CodreanuDan/ECG_Monitor-ECG_Mon/Docs/2/ECG_Presentation_PDF.pdf

# Dispozitiv de monitorizare a

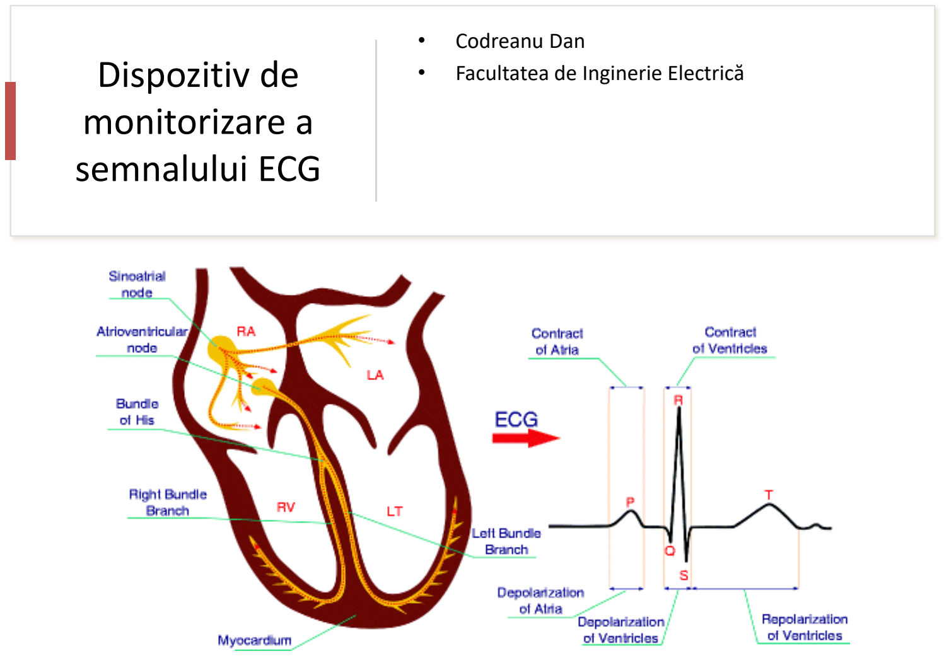
[picture p47: page 1]

# semnalului ECG

- Codreanu Dan
- Facultatea de Inginerie Electrică

# Context & Stadiul actual

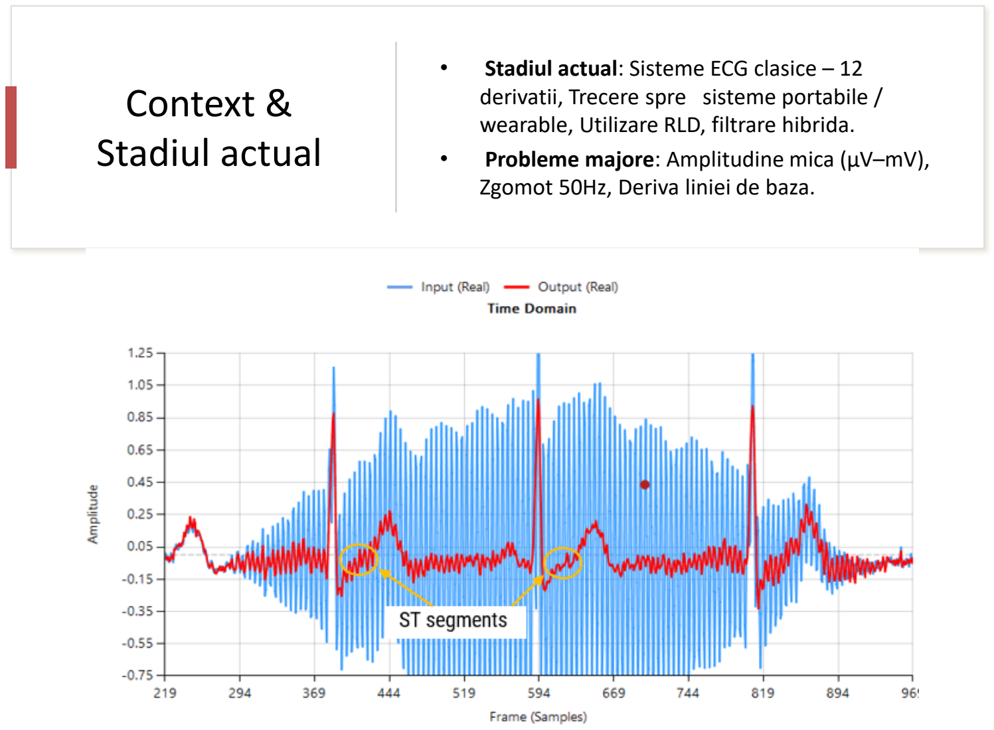
[picture p48: page 2]

- Stadiul actual: Sisteme ECG clasice – 12 derivatii, Trecere spre sisteme portabile / wearable, Utilizare RLD, filtrare hibrida.
- Probleme majore: Amplitudine mica (µV–mV), Zgomot 50Hz, Deriva liniei de baza.

# Obiectivul lucrarii

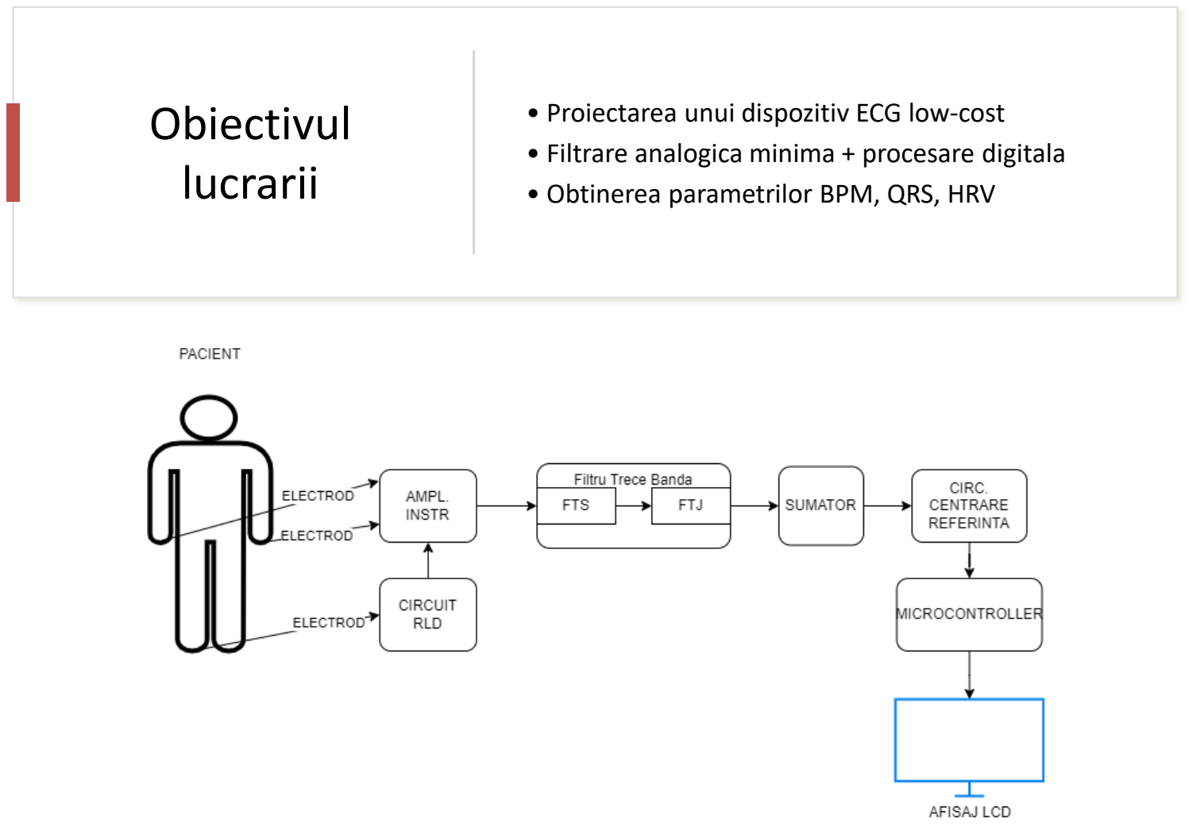
[picture p49: page 3]

- Proiectarea unui dispozitiv ECG low

-cost
- Filtrare analogica minima + procesare digitala
- Obtinerea parametrilor BPM, QRS, HRV

# Contributii personale si implementare

# - Generare semnal ECG (Python) - Model pacient cu simulare zgomot 50Hz - Lant analogic: AD620 + RLD + filtre active Sallen Key - Corectie offset + centrare ADC - Algoritmi software:

- R-peak,
- BPM,
- QRS,

## - HRV (SDNN, RMSSD, pNN50)

# - Afisarea datelor pe un ecran LCD

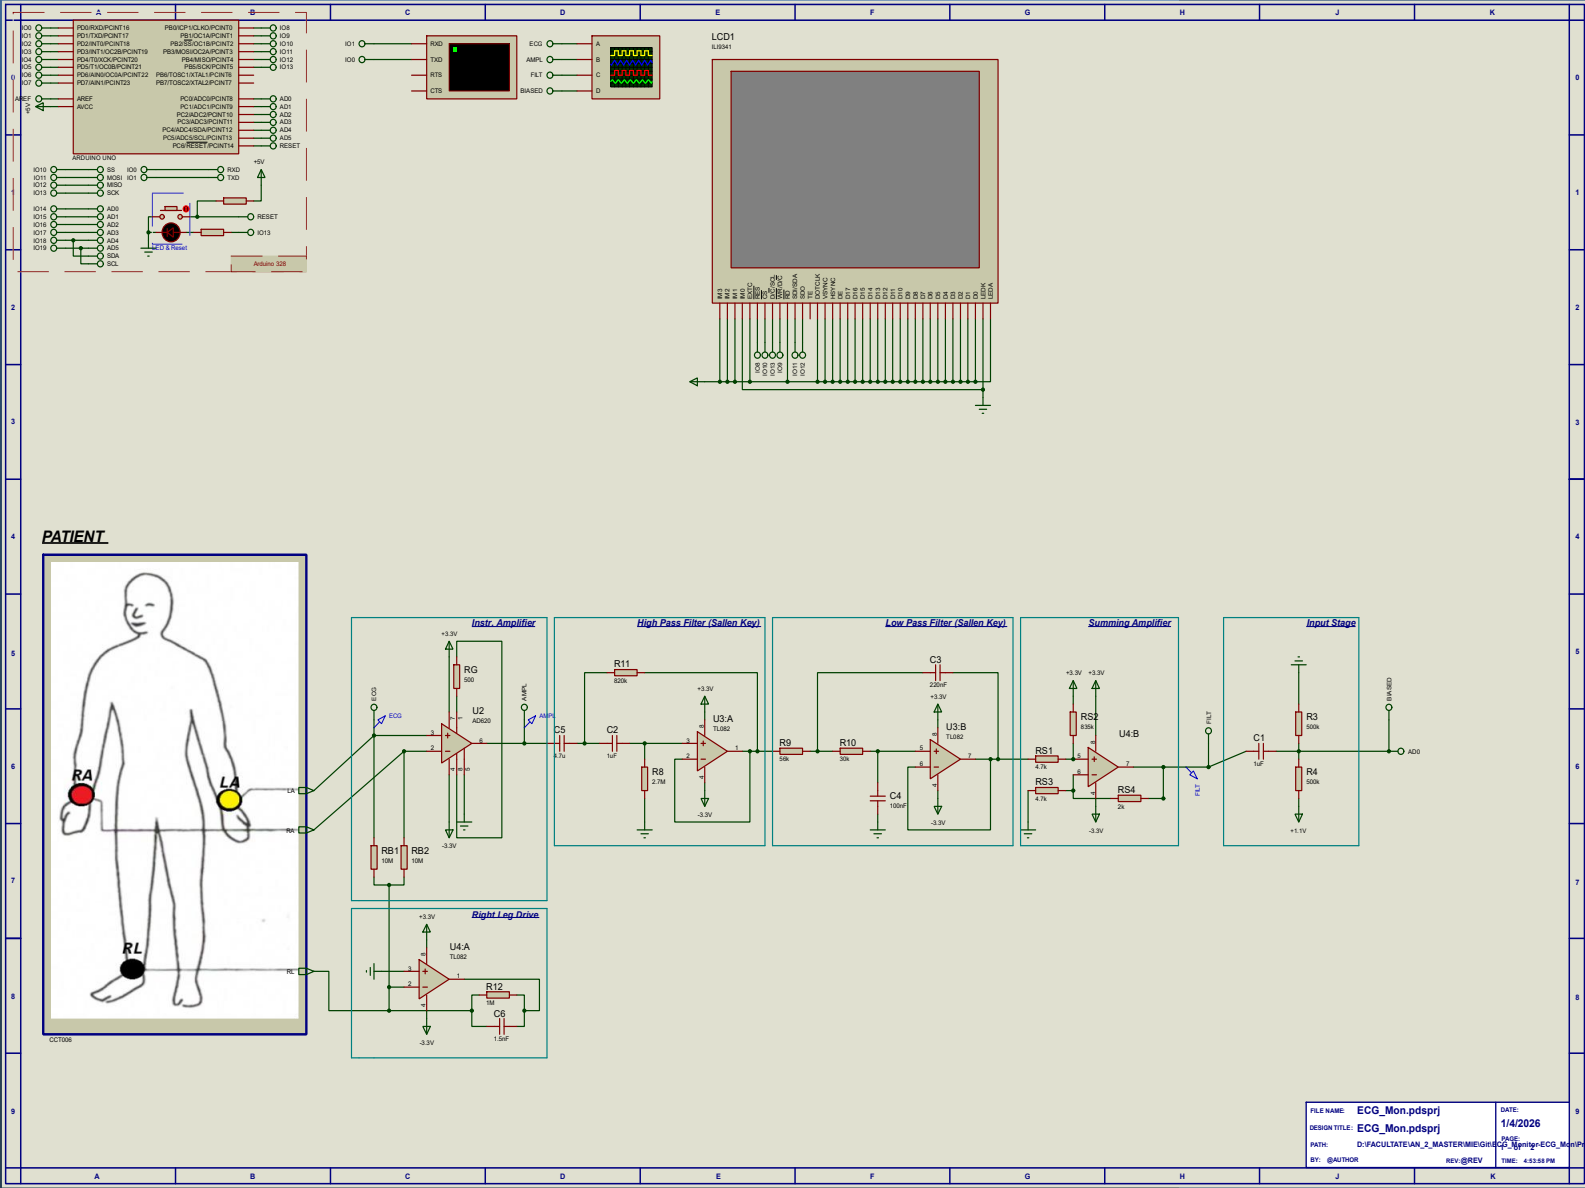
[picture p50: page 5]

# Metodologie & validare

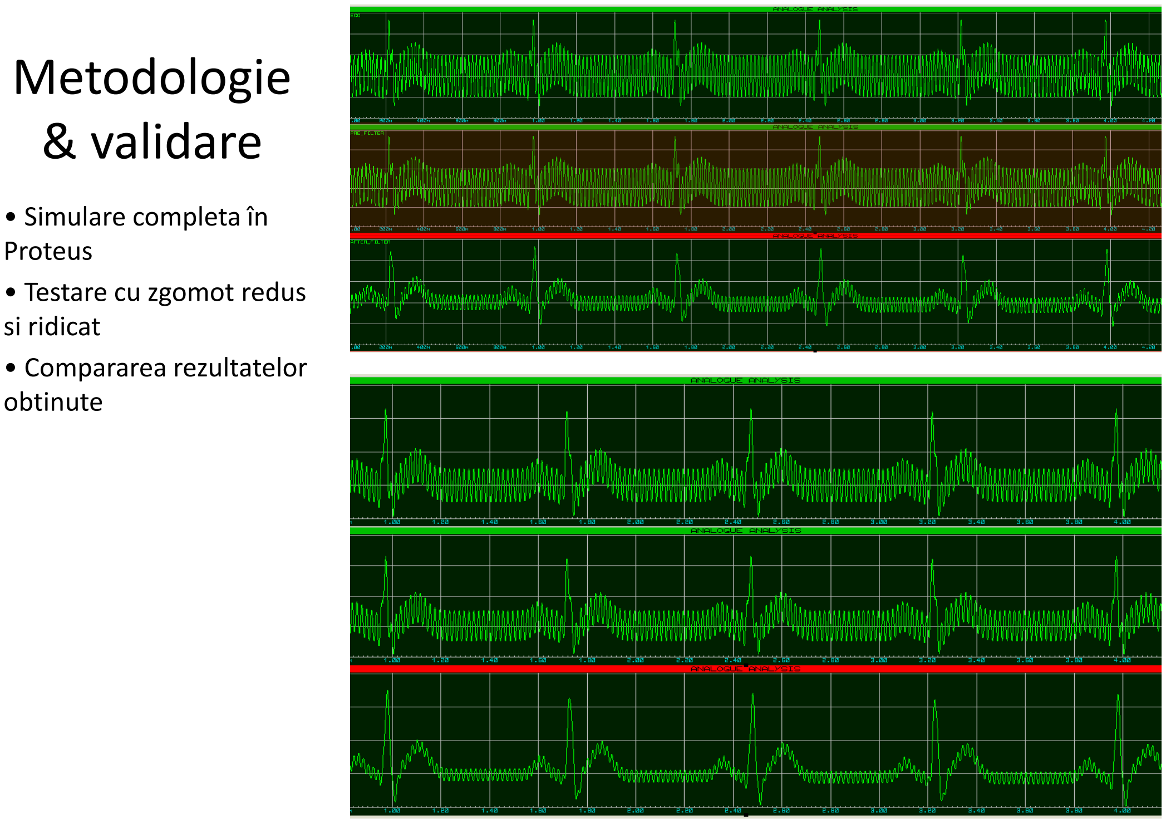
[picture p51: page 6]

- Simulare completa în
Proteus
- Testare cu zgomot redus
si ridicat
- Compararea rezultatelor
obtinute

# Rezultate

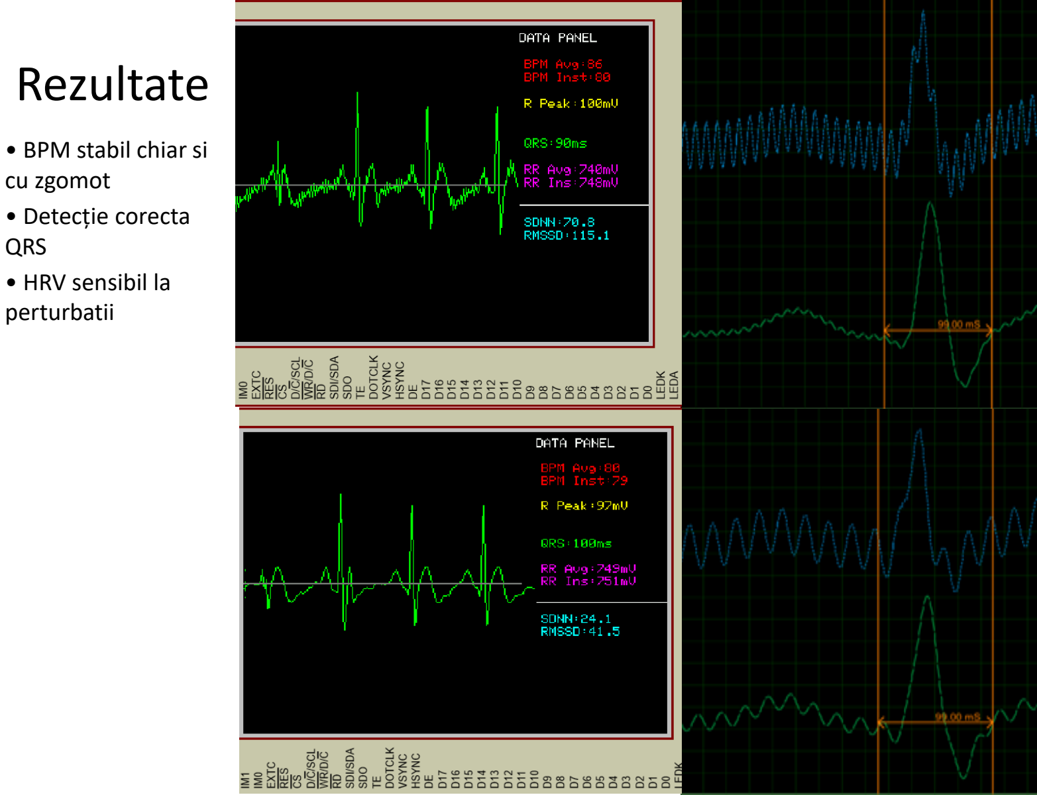
[picture p52: page 7]

- BPM stabil chiar si
cu zgomot
- Detecție corecta
QRS
- HRV sensibil la
perturbatii

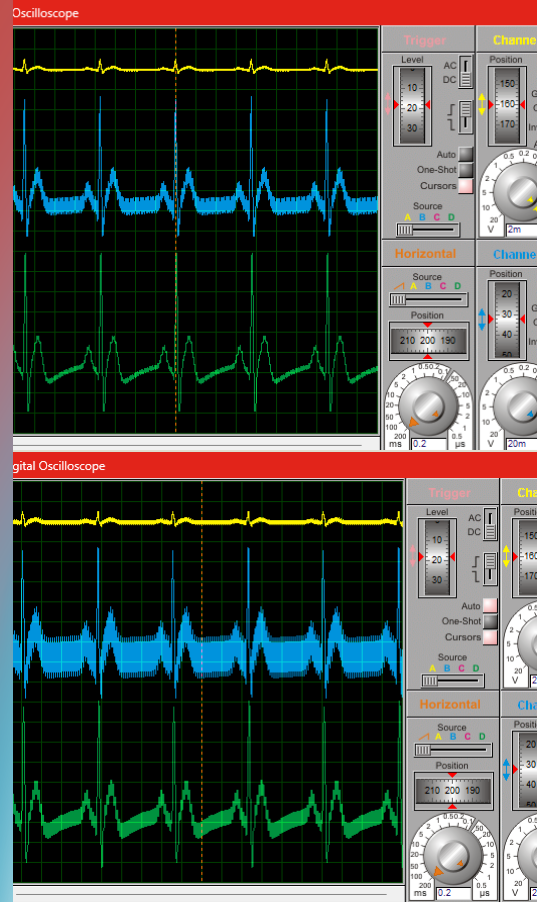
[picture p53: figure]

# Concluzii & dezvoltari viitoare

- Filtrare hibrida eficienta
- Sistem stabil pe platforma simpla
- Posibil upgrade hardware si testare reala
