CodreanuDan/ECG_Monitor-ECG_Mon/Docs/img/Ampl_high_noise.png

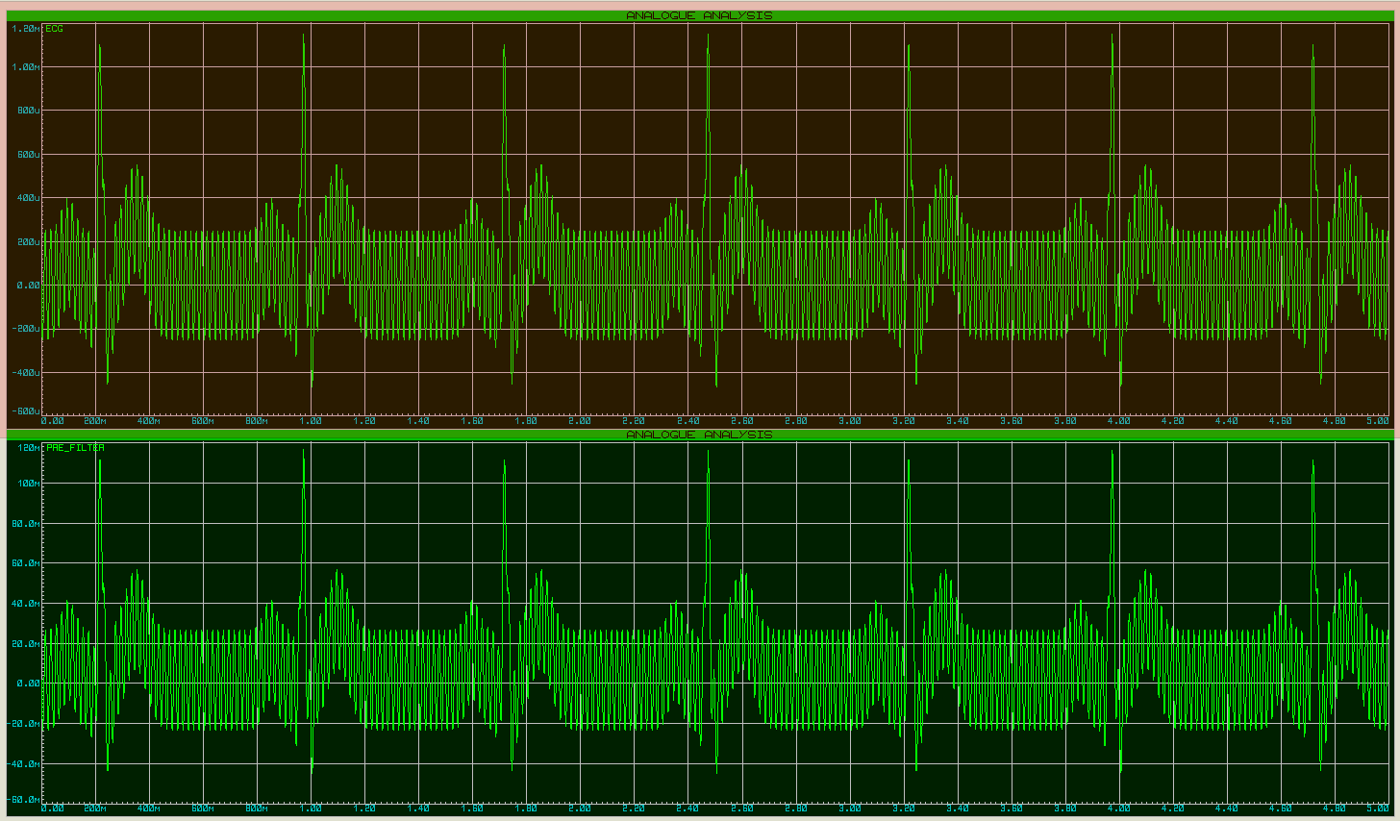
Docs/img/Ampl_high_noise.png
