CodreanuDan/ECG_Monitor-ECG_Mon/Docs/img/Ampl_low_noise.png

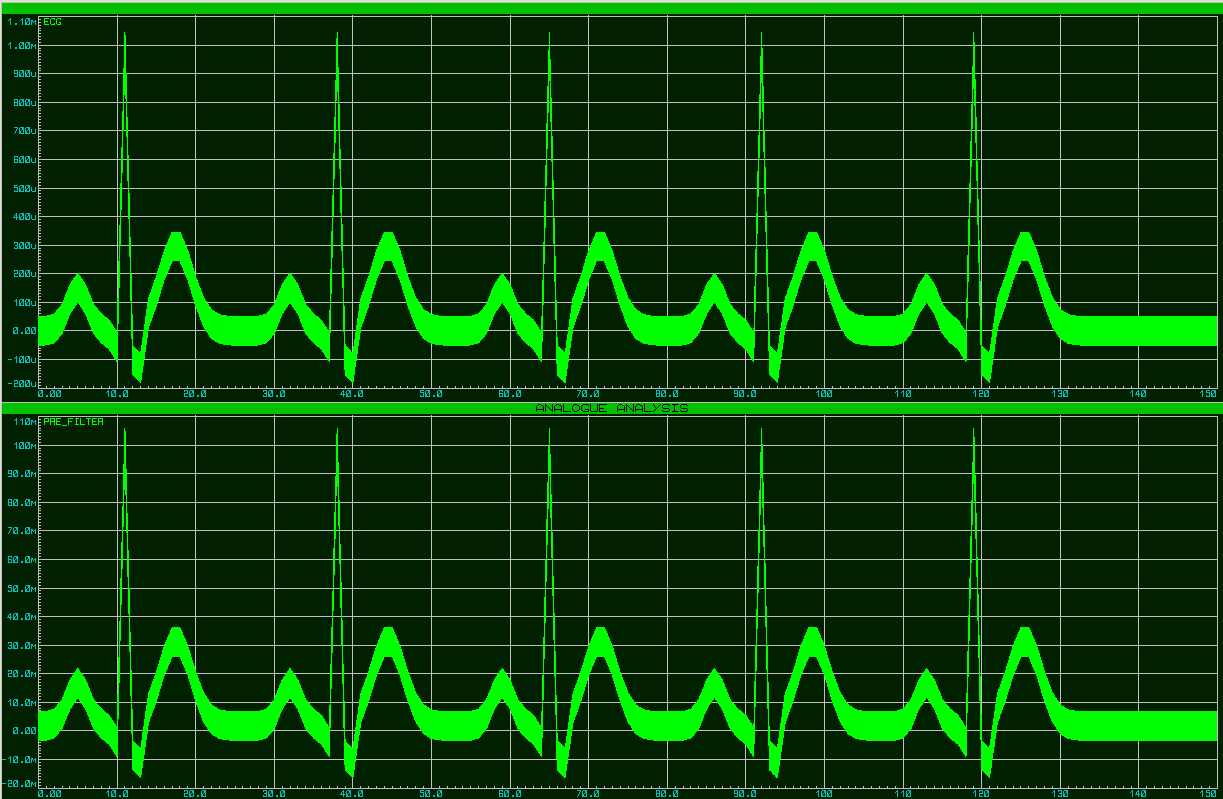
Docs/img/Ampl_low_noise.png
