CodreanuDan/ECG_Monitor-ECG_Mon/Docs/img/Ampl_unified.png

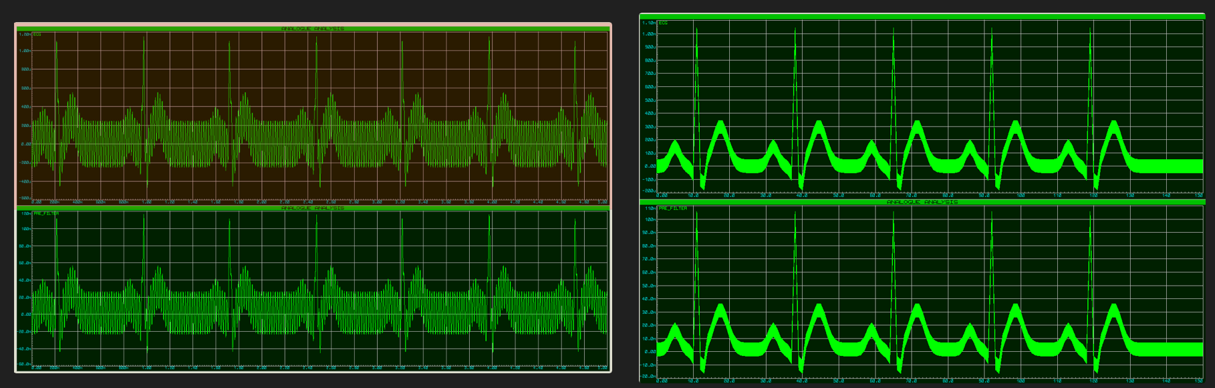
Docs/img/Ampl_unified.png
