CodreanuDan/ECG_Monitor-ECG_Mon/Docs/img/Cardiac-Cycle-Animated.gif

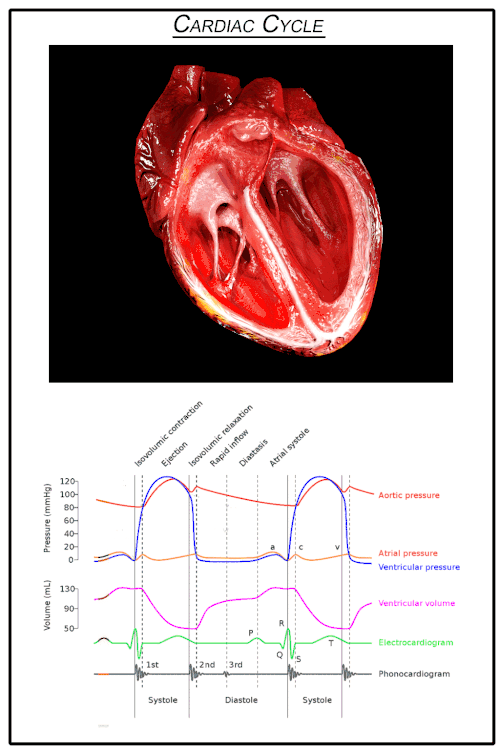
Docs/img/Cardiac-Cycle-Animated.gif
