CodreanuDan/ECG_Monitor-ECG_Mon/Docs/img/Gemini_Generated_Image_ncsioyncsioyncsi.png

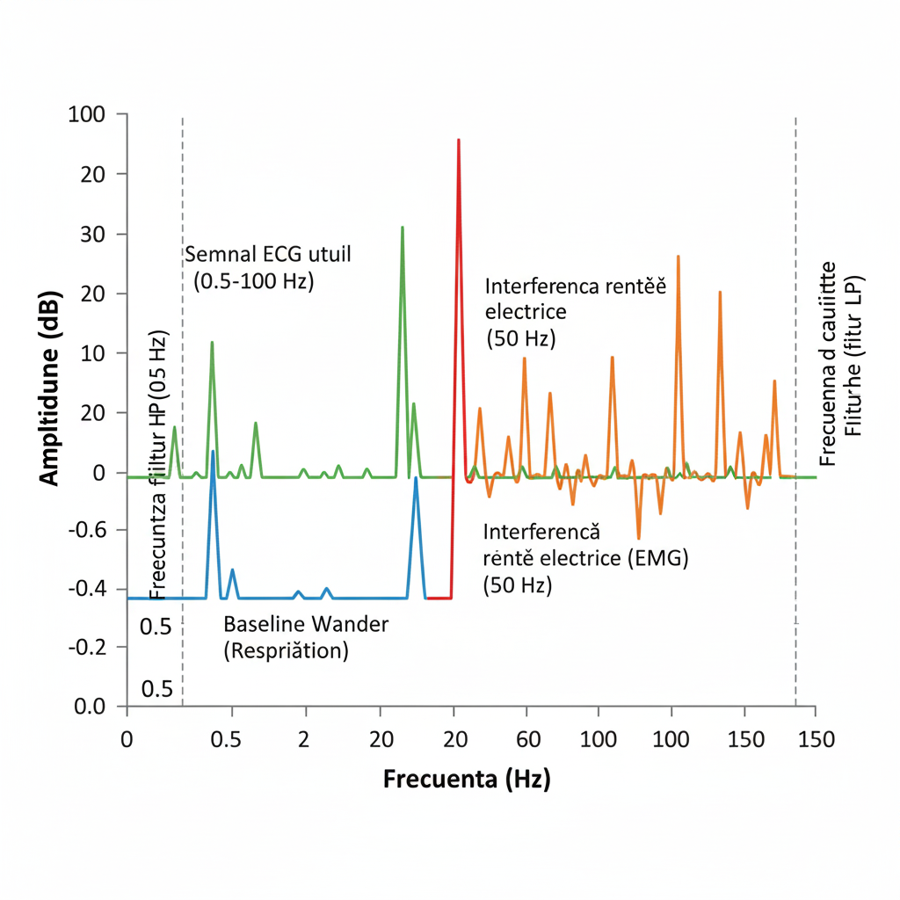
Docs/img/Gemini_Generated_Image_ncsioyncsioyncsi.png
