CodreanuDan/ECG_Monitor-ECG_Mon/Docs/img/Inside_patient.png

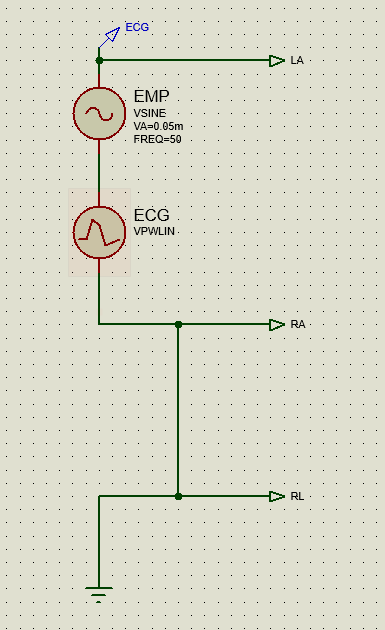
Docs/img/Inside_patient.png
