CodreanuDan/ECG_Monitor-ECG_Mon/Docs/img/Simulare_fara_TFT.png

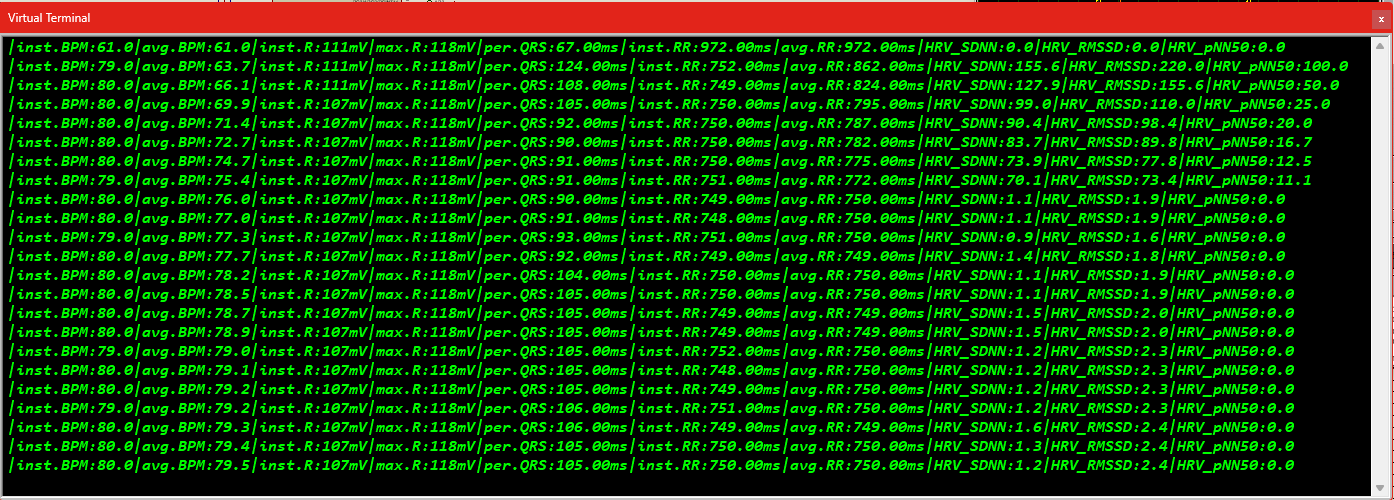
Docs/img/Simulare_fara_TFT.png
