CodreanuDan/ECG_Monitor-ECG_Mon/Docs/img/Timer Interrupt Arduino.png

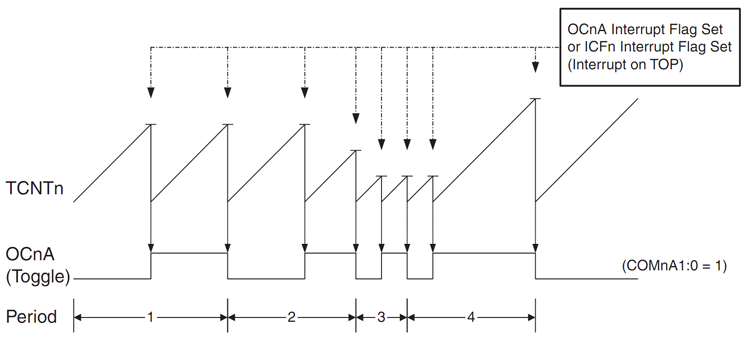
Docs/img/Timer Interrupt Arduino.png
