CodreanuDan/ECG_Monitor-ECG_Mon/Docs/img/WhatsApp Image 2026-01-04 at 14.37.44.jpeg

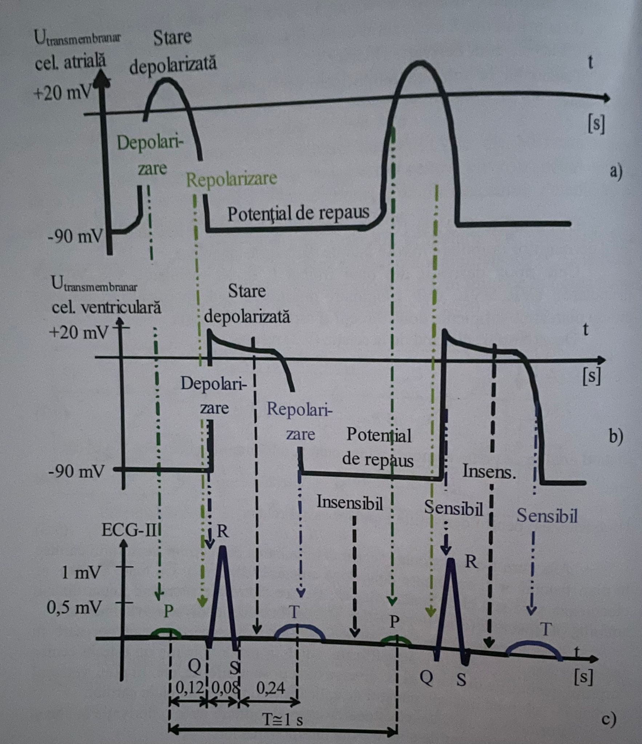
Docs/img/WhatsApp Image 2026-01-04 at 14.37.44.jpeg
