CodreanuDan/ECG_Monitor-ECG_Mon/Docs/img/RLD_Setup.png

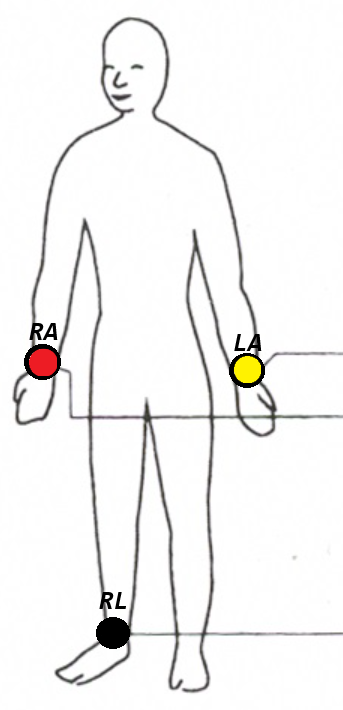
Docs/img/RLD_Setup.png
