CodreanuDan/ECG_Monitor-ECG_Mon/Docs/results/FiltrareLive.pdf

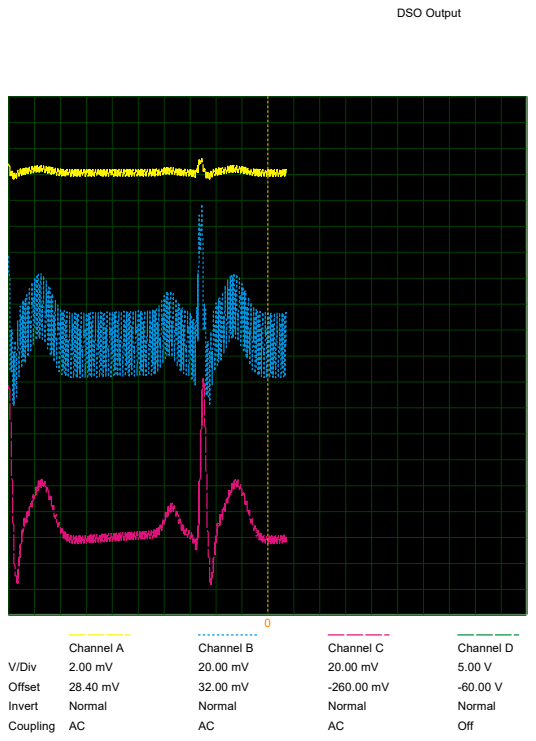
[picture p64: page 1]
DSO Output; V/Div Offset Invert Coupling; Channel A 2.00 mV 28.40 mV Normal AC; Channel B 20.00 mV 32.00 mV Normal AC; Channel C 20.00 mV -260.00 mV Normal AC; Channel D 5.00 V -60.00 V Normal Off
