CodreanuDan/ECG_Monitor-ECG_Mon/Docs/results/QRS_WIDTH.pdf

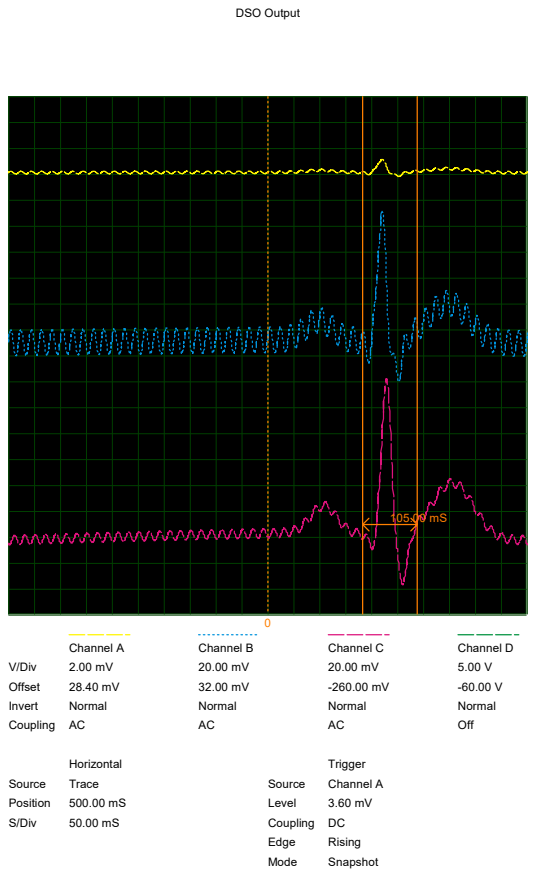
[picture p65: page 1]
DSO Output; V/Div Offset Invert Coupling; Channel A 2.00 mV 28.40 mV Normal AC; Channel B 20.00 mV 32.00 mV Normal AC; Channel C 20.00 mV -260.00 mV Normal AC; Channel D 5.00 V -60.00 V Normal Off; Horizontal; Source Position S/Div; Trace 500.00 mS 50.00 mS; Trigger; Source Level Coupling Edge Mode; Channel A 3.60 mV DC Rising Snapshot
