CodreanuDan/ECG_Monitor-ECG_Mon/Docs/results/QRS_WIDTH_with_TFT.pdf

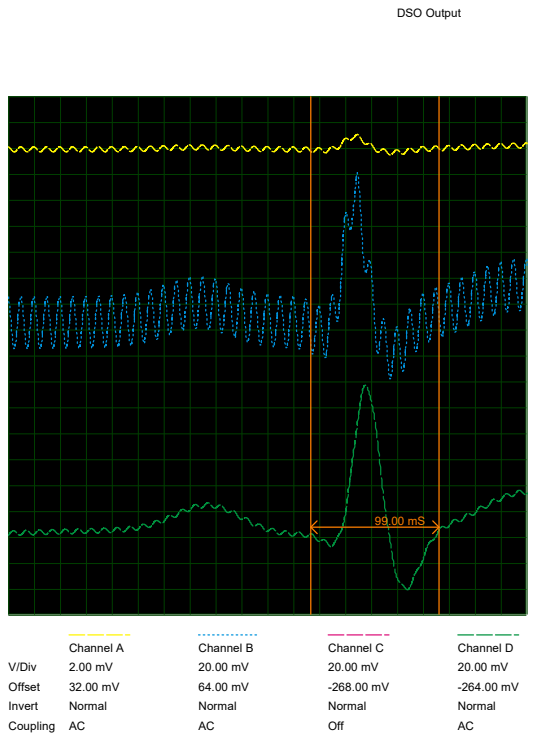
[picture p66: page 1]
DSO Output; V/Div Offset Invert Coupling; Channel A 2.00 mV 32.00 mV Normal AC; Channel B 20.00 mV 64.00 mV Normal AC; Channel C 20.00 mV -268.00 mV Normal Off; Channel D 20.00 mV -264.00 mV Normal AC
