CodreanuDan/ECG_Monitor-ECG_Mon/(list of files, drawings)

Other design files:
Proteus_Sim/Drafts/OldWithoutTFT/ECG_Mon_beforeTFT.pdsprj
Proteus_Sim/Drafts/Test_BiasVoltage/ECG_Mon_testBias.pdsprj
Proteus_Sim/Drafts/TestHMIIoT/ECG_Mon_HMI.pdsprj
Proteus_Sim/Drafts/TestHMIIoT/ECG_Mon_test_IoT.pdsprj
Proteus_Sim/Drafts/TestPWLIN/Test_PWLIN.pdsprj
Proteus_Sim/Drafts/TestTFT/TestTFT.pdsprj
Proteus_Sim/Drafts/withoutCommonModeRejection/ECG_Mon_NoRej.pdsprj
Proteus_Sim/ECG_Mon.pdsprj
